kairotronix/kt_sound_pcb/README.md

# kt_sound_pcb

This is the schematic and PCB design files for interfacing with the DE10-Nano development kit for the KT Sound FPGA synthesizer design.
