kairotronix/kt_sound_pcb/DOC/kt_sound_prototypeiface.pdf

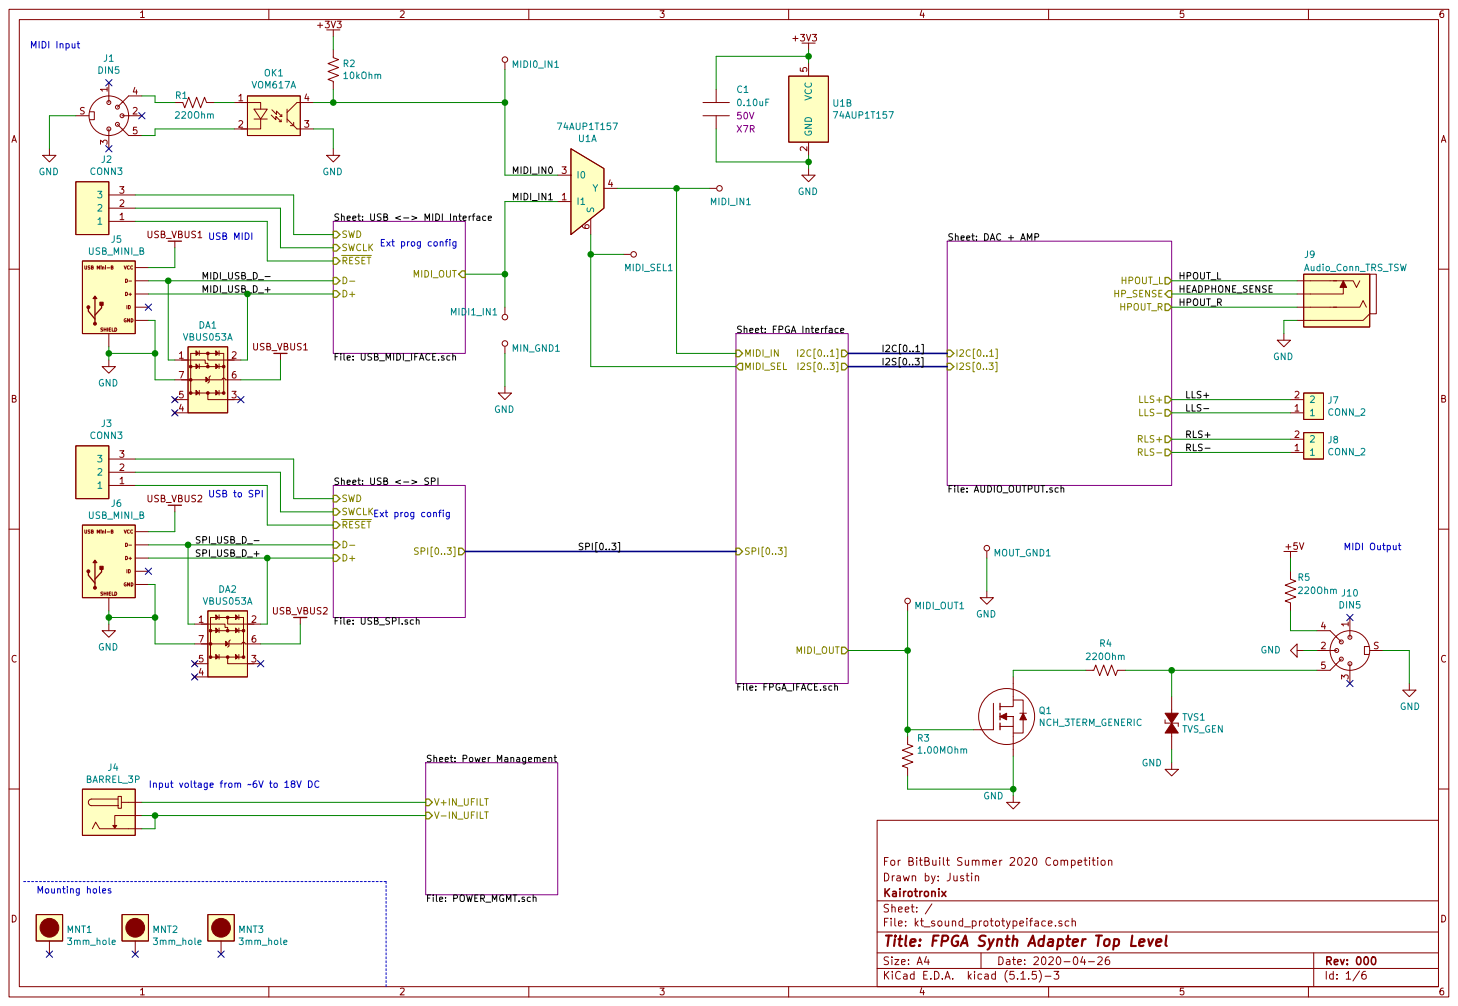
[picture p1: page 1]

I2C[0..1] | HPOUT_L HPOUT_R HP_SENSE LLS+

SWD Ext prog config

Input voltage from 6V to 18V DC

For BitBuilt Summer 2020 Competition
File: kt_sound_prototypeiface.sch Sheet: / Kairotronix Drawn by: Justin

Id: 1/6 Title: FPGA Synth Adapter Top Level

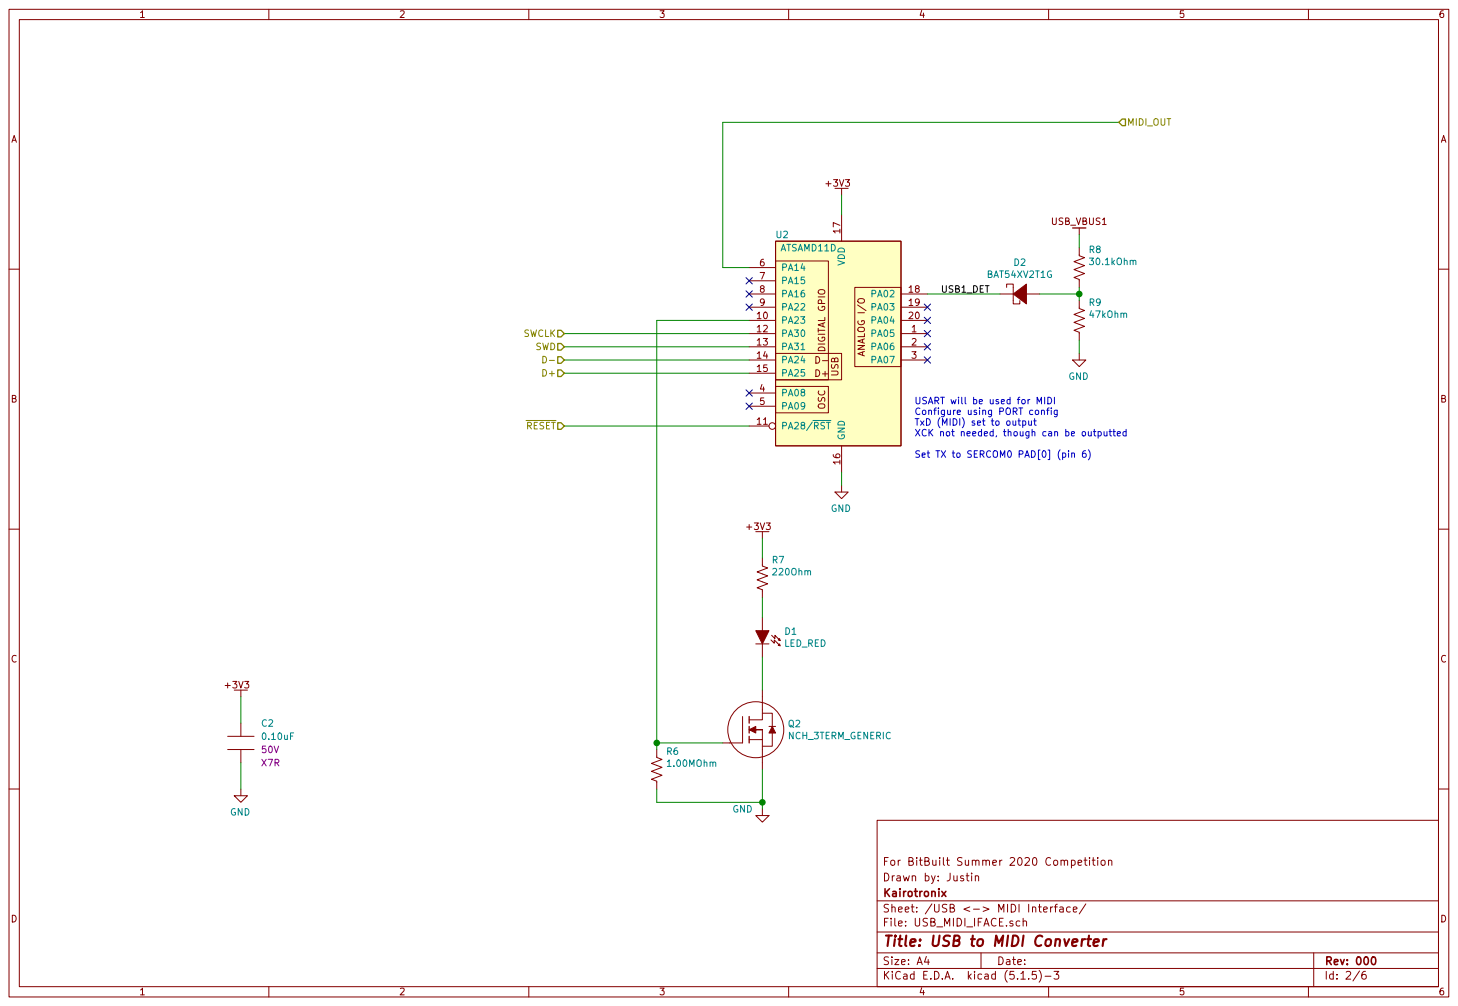
[picture p2: page 2]

TxD (MIDI) set to output
XCK not needed, though can be outputted

Set TX to SERCOM0 PAD[0] (pin 6)

For BitBuilt Summer 2020 Competition R6
1.00MOhm

File: USB_MIDI_IFACE.sch Sheet: /USB <-> MIDI Interface/ Kairotronix Drawn by: Justin

Id: 2/6 Title: USB to MIDI Converter

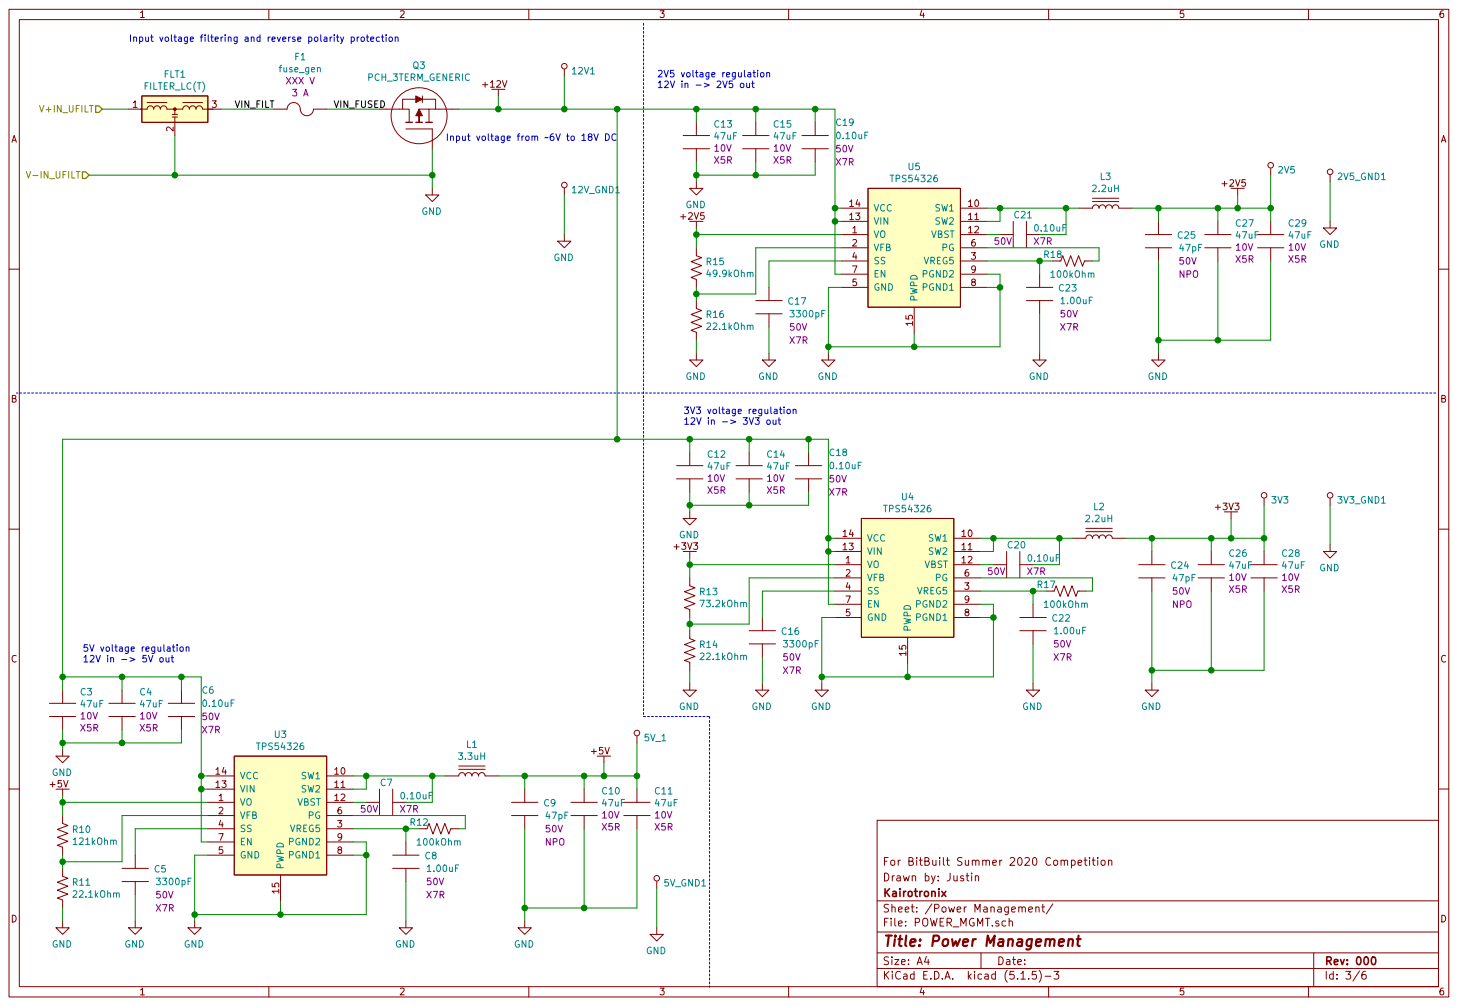
[picture p3: page 3]

Input voltage filtering and reverse polarity protection
3 FLT1 FILTER_LC(T) GND

12V_GND1 +12V Q3 PCH_3TERM_GENERIC GND
12V in -> 3V3 out 2V5 voltage regulation
12V in -> 2V5 out

Input voltage from 6V to 18V DC

For BitBuilt Summer 2020 Competition
Sheet: /Power Management/ Kairotronix Drawn by: Justin

File: POWER_MGMT.sch
Id: 3/6 Title: Power Management

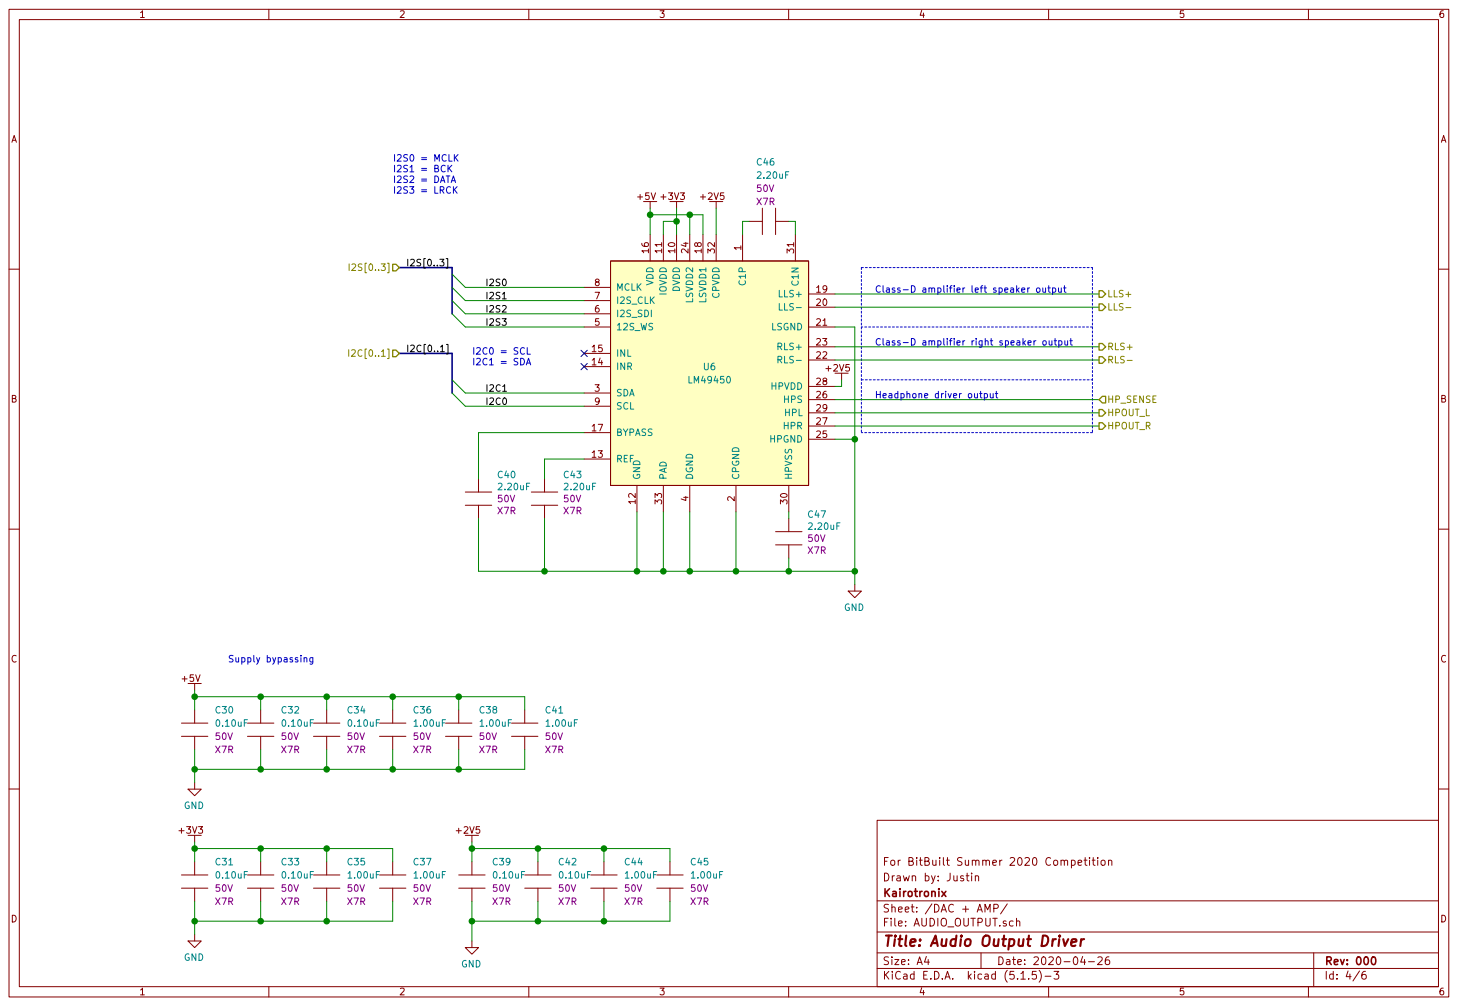
[picture p4: page 4]

1 DVDD 10 IOVDD 11 GND 12 REF 13

RLS+ RLS- LLS- LLS+ HP_SENSE HPOUT_R

Class-D amplifier right speaker output

For BitBuilt Summer 2020 Competition
File: AUDIO_OUTPUT.sch Sheet: /DAC + AMP/ Kairotronix Drawn by: Justin

Id: 4/6 Title: Audio Output Driver

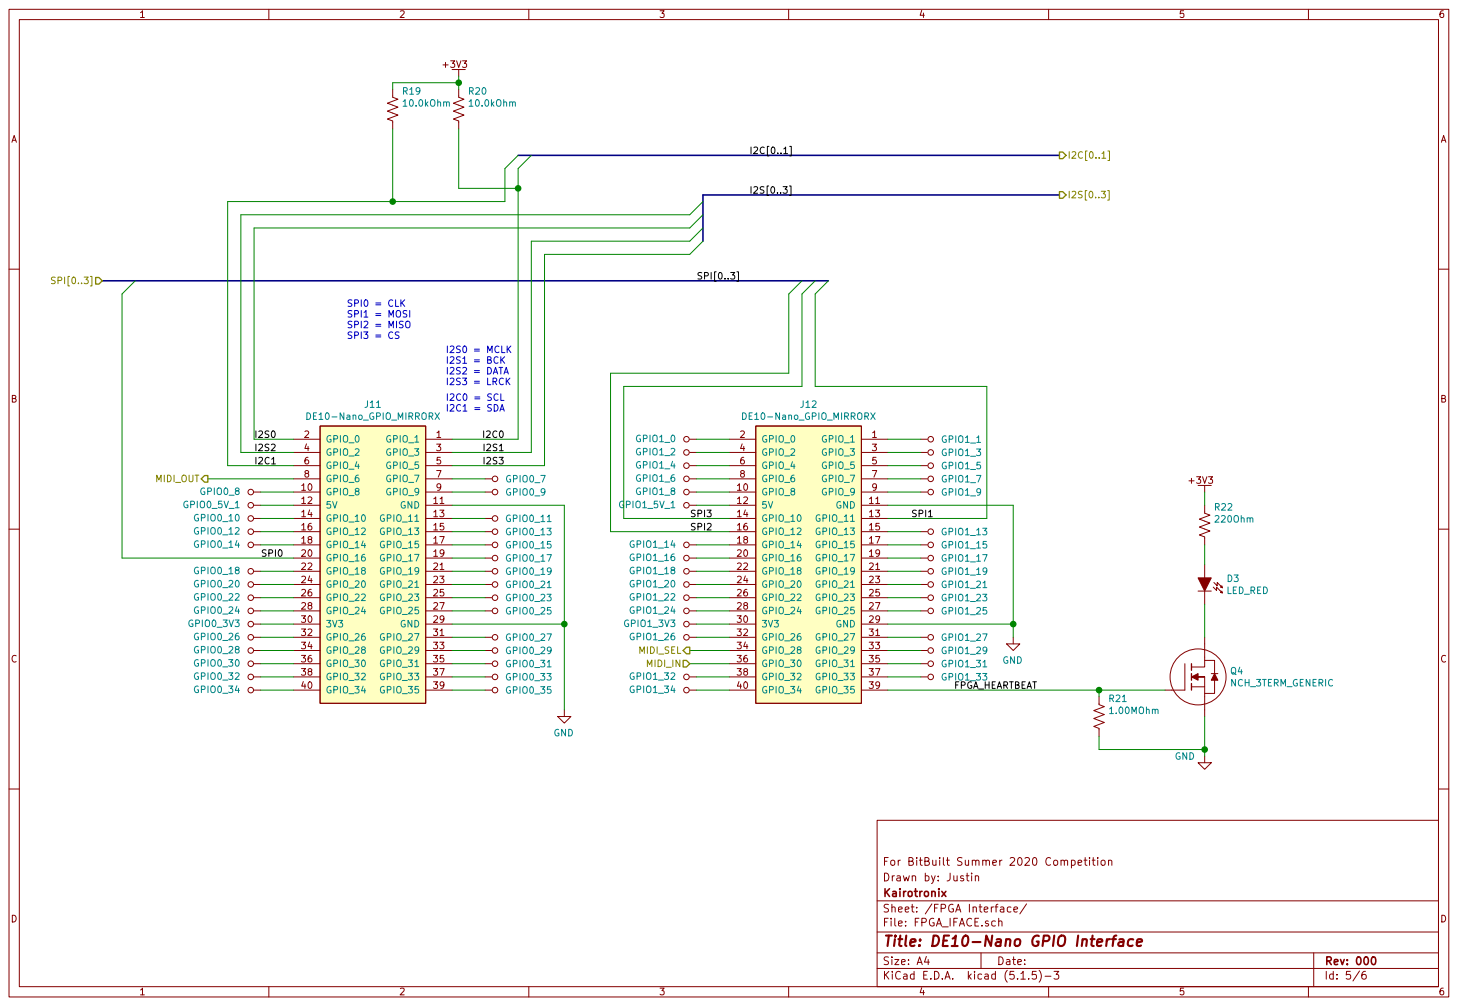
[picture p5: page 5]

File: FPGA_IFACE.sch Sheet: /FPGA Interface/ Kairotronix Drawn by: Justin

Id: 5/6 Title: DE10-Nano GPIO Interface

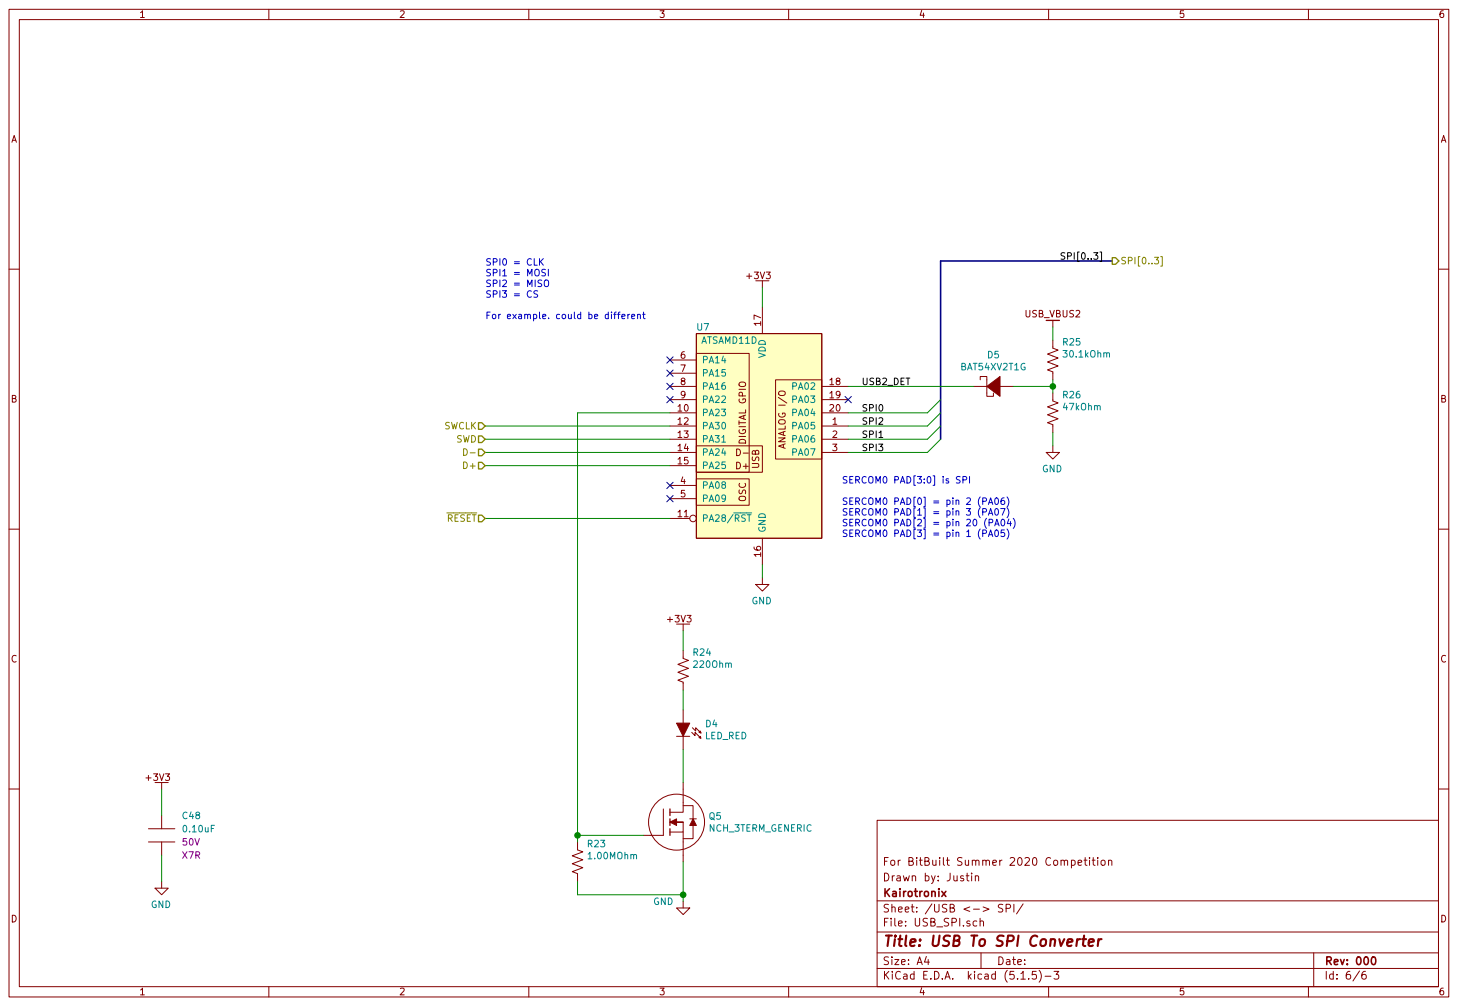
[picture p6: page 6]

For BitBuilt Summer 2020 Competition GND

For example. could be different

File: USB_SPI.sch Sheet: /USB <-> SPI/ Kairotronix Drawn by: Justin

Id: 6/6 Title: USB To SPI Converter
