kairotronix/kt_sound_pcb/kt_sound_prototypeiface.kicad_pcb

## KiCad design kt_sound_prototypeiface.kicad_pcb (2020-05-19)

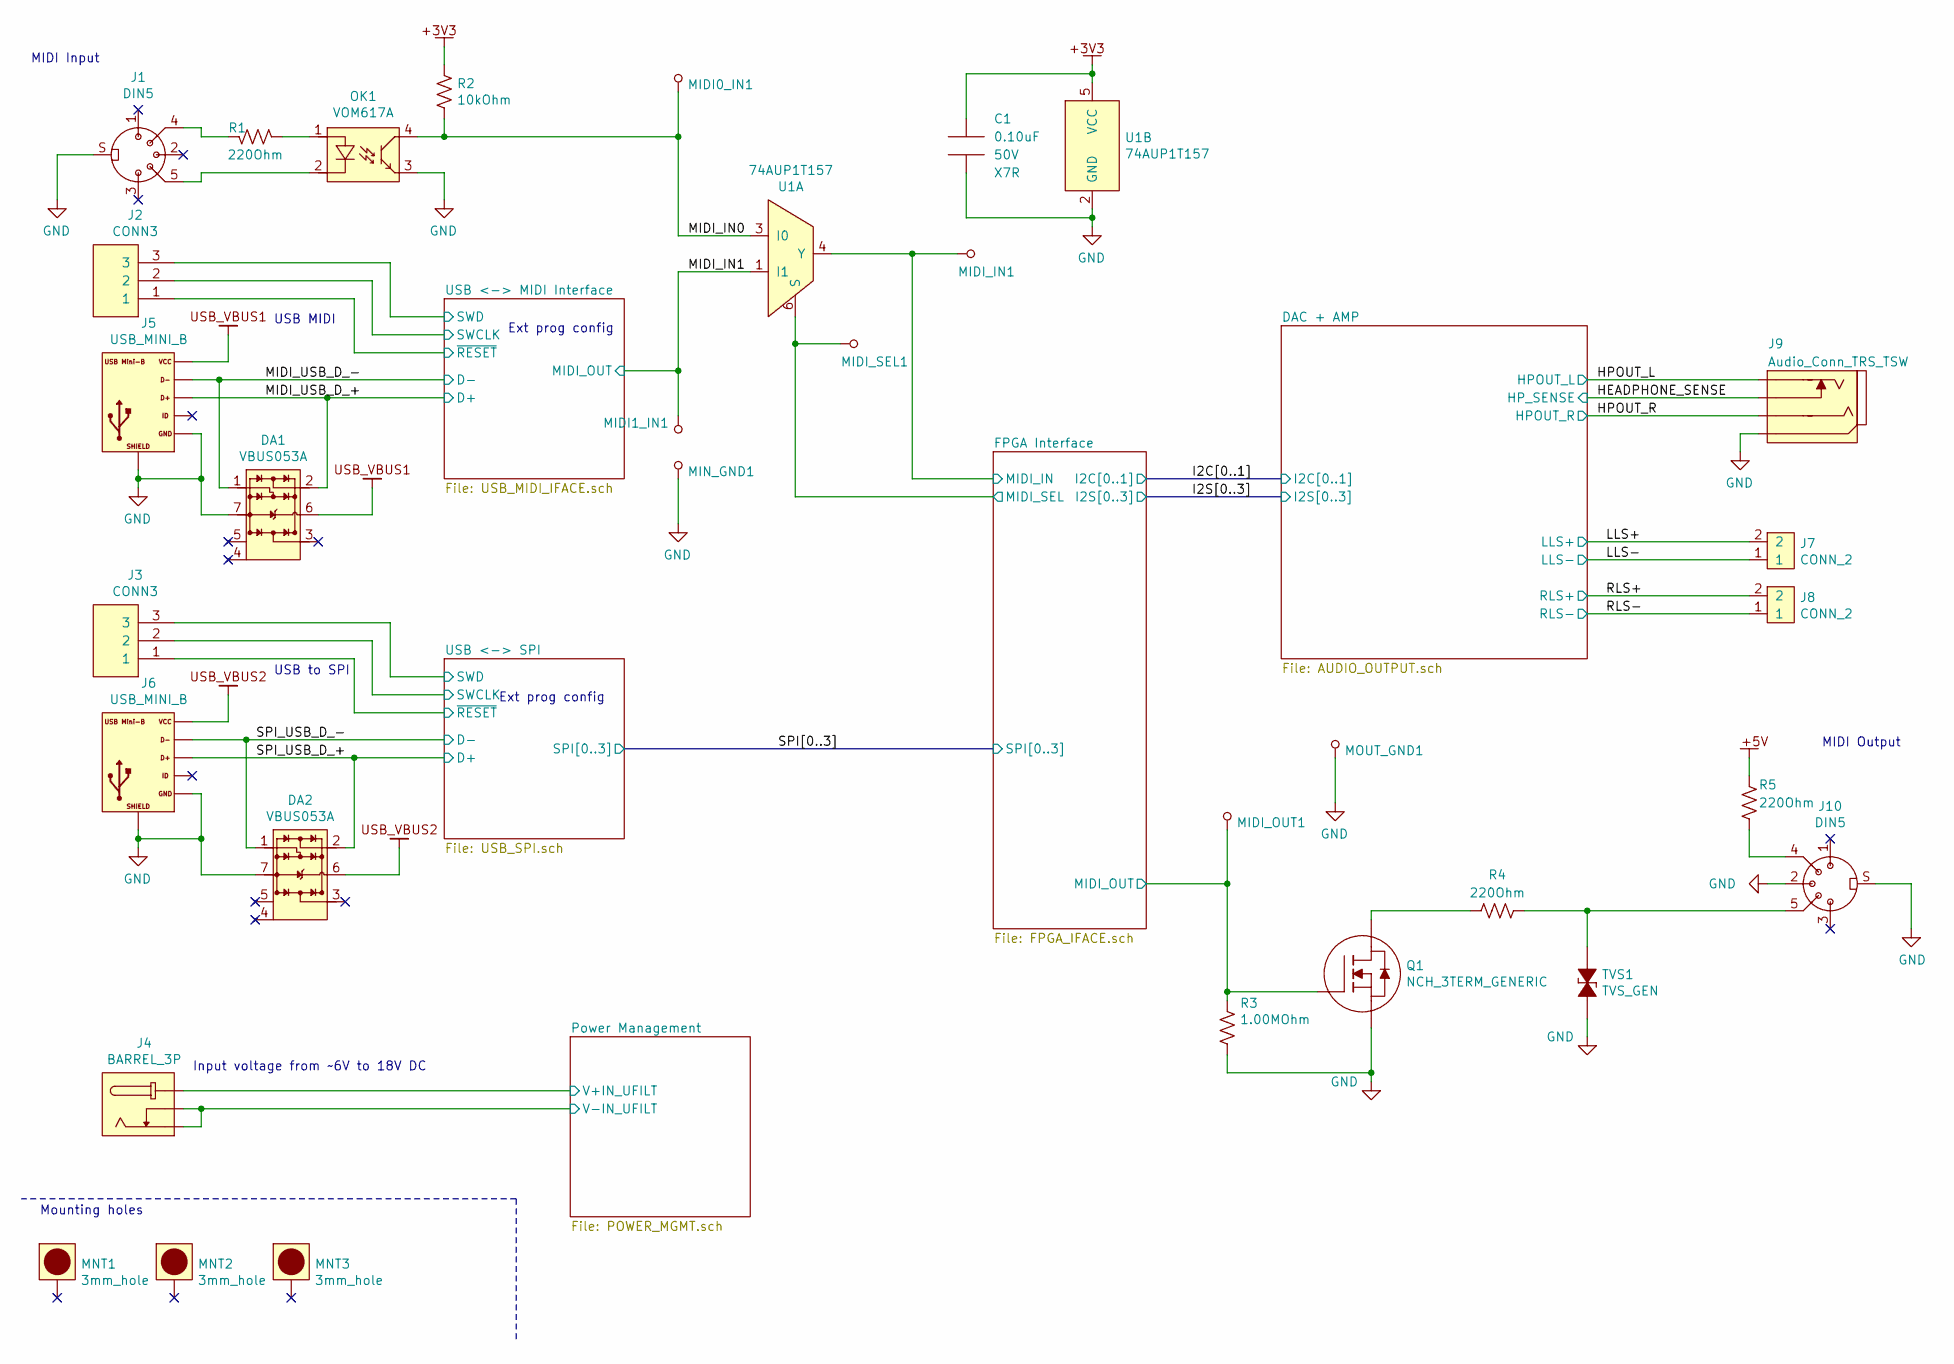
[picture p7: schematic kt_sound_prototypeiface.sch, FPGA Synth Adapter Top Level]

Parts:
C1: 0.10uF; CAP_0603; Voltage 50V; Tolerance XX %
DA1, DA2: VBUS053A; UFDFN-6-EP; MFG1 P/N VBUS053A
J1, J10: DIN5; DIN-5-CUI
J2, J3: CONN3; 1x03_0.1inch_vertical_header
J4: BARREL_3P; BarrelJack_CUI_PJ-102B; MFG1 P/N MFG1 P/N
J5, J6: USB_MINI_B; USB_MINIB_THT_TE_2172034-1
J7, J8: CONN_2; 1x02_0.1inch_vertical_header; MFG1 P/N MFG1 P/N
J9: Audio_Conn_TRS_TSW; Jack_3.5mm_CUI_SJ-3524-SMT; MFG1 P/N MFG1 P/N
MIDI0_IN1, MIDI1_IN1: TP_SMALL; TP_1mm; MFG P/N N/A
MIDI_IN1: TP_SMALL; TP_1mm; MFG P/N N/A
MIDI_OUT1: TP_SMALL; TP_1mm; MFG P/N N/A
MIDI_SEL1: TP_SMALL; TP_1mm; MFG P/N N/A
MIN_GND1: TP_SMALL; TP_1mm; MFG P/N N/A
MNT1, MNT2, MNT3: 3mm_hole; mnt_3mm_plated
MOUT_GND1: TP_SMALL; TP_1mm; MFG P/N N/A
OK1: VOM617A; 4-SMD_GW; MFG1 P/N VOM617A
Q1: NCH_3TERM_GENERIC; SOT23
R1: 220Ohm; RES_0603; Tolerance XX %
R2: 10kOhm; RES_0603; Tolerance XX %
R3: 1.00MOhm; RES_0603; Tolerance 10 %
R4, R5: 220Ohm; RES_0603; Tolerance 10 %
TVS1: TVS_GEN; SOD-523; Voltage - Reverse Stand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 X V; Voltage - Breakdown X V; MFG1 P/N MFG1 P/N
U1: 74AUP1T157; TSSOP-6; MFG1 P/N SN74AUP1T157

Connections:
3V3: C1.1, R2.1, U1.5 (VCC); also elsewhere on the board
5V: R5.2; also elsewhere on the board
/FPGA Interface/MIDI_IN: MIDI_IN1.1, U1.4 (Y); also elsewhere on the board
/FPGA Interface/MIDI_OUT: MIDI_OUT1.1, Q1.1 (G), R3.1; also elsewhere on the board
/FPGA Interface/MIDI_SEL: MIDI_SEL1.1, U1.6 (S); also elsewhere on the board
/HEADPHONE_SENSE: J9.10 (TS); also elsewhere on the board
/HPOUT_L: J9.2 (T); also elsewhere on the board
/HPOUT_R: J9.3 (R); also elsewhere on the board
/LLS+: J7.2; also elsewhere on the board
/LLS-: J7.1; also elsewhere on the board
/MIDI_IN0: MIDI0_IN1.1, OK1.4, R2.2, U1.3 (I0)
/MIDI_IN1: MIDI1_IN1.1, U1.1 (I1); also elsewhere on the board
/MIDI_USB_D_+: DA1.2 (I/O), J5.3; also elsewhere on the board
/MIDI_USB_D_-: DA1.1 (I/O), J5.2; also elsewhere on the board
/Power Management/V+IN_UFILT: J4.1 (BARREL); also elsewhere on the board
/RLS+: J8.2; also elsewhere on the board
/RLS-: J8.1; also elsewhere on the board
/SPI_USB_D_+: DA2.2 (I/O), J6.3; also elsewhere on the board
/SPI_USB_D_-: DA2.1 (I/O), J6.2; also elsewhere on the board
/USB <-> MIDI Interface/SWCLK: J2.2; also elsewhere on the board
/USB <-> MIDI Interface/SWD: J2.3; also elsewhere on the board
/USB <-> MIDI Interface/~RESET: J2.1; also elsewhere on the board
/USB <-> SPI/SWCLK: J3.2; also elsewhere on the board
/USB <-> SPI/SWD: J3.3; also elsewhere on the board
/USB <-> SPI/~RESET: J3.1; also elsewhere on the board
GND: C1.2, DA1.7 (GND), DA2.7 (GND), J1.S, J4.2 (SHIELD), J4.3 (CONTACT), J5.5, J5.SHIELD, J6.5, J6.SHIELD, J9.1 (S), J10.2, J10.S, MIN_GND1.1, MOUT_GND1.1, OK1.3, Q1.2 (S), R3.2, TVS1.2, U1.2 (GND); also elsewhere on the board
unnamed: J1.4, R1.1
unnamed: J1.5, OK1.2
unnamed: J10.4, R5.1
unnamed: J10.5, R4.1, TVS1.1
unnamed: OK1.1, R1.2
unnamed: Q1.3 (D), R4.2
USB_VBUS1: DA1.6 (V-), J5.1; also elsewhere on the board
USB_VBUS2: DA2.6 (V-), J6.1; also elsewhere on the board

Notes on the sheet:
USB to SPI
USB MIDI
MIDI Output
MIDI Input
Ext prog config
Input voltage from ~~6V to 18V DC
Mounting holes

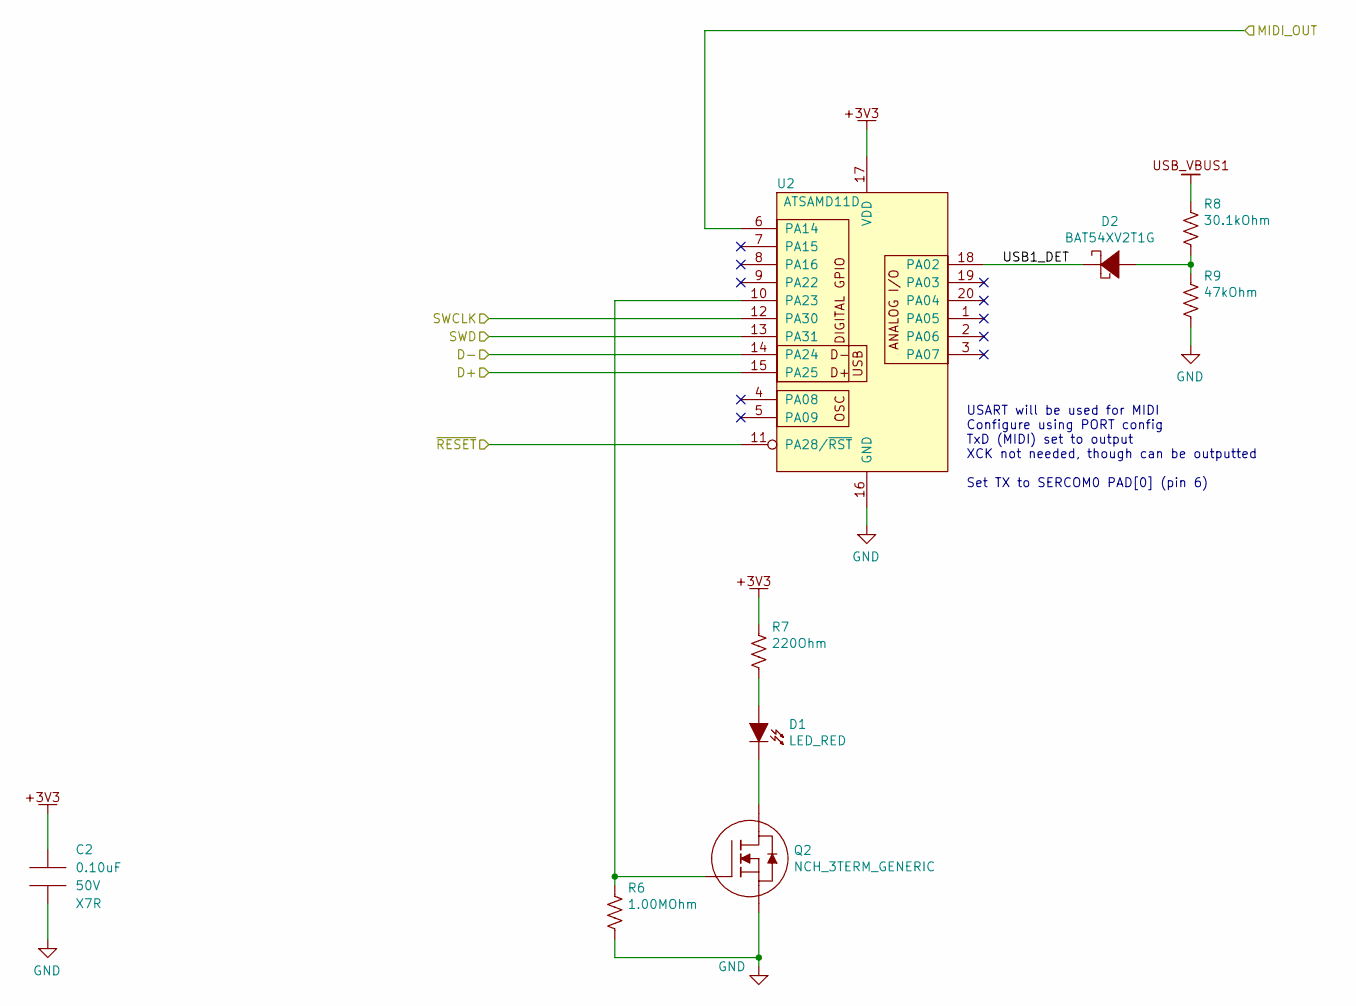
[picture p8: schematic USB_MIDI_IFACE.sch, USB to MIDI Converter]

Parts:
C2: 0.10uF; CAP_0603; Voltage 50V; Tolerance XX %
D1: LED_RED; LED_0805
D2: BAT54XV2T1G; SOD-523
Q2: NCH_3TERM_GENERIC; SOT23
R6: 1.00MOhm; RES_0603; Tolerance 10 %
R7: 220Ohm; RES_0603; Tolerance XX %
R8: 30.1kOhm; RES_0603; Tolerance XX %
R9: 47kOhm; RES_0603; Tolerance XX %
U2: ATSAMD11D; SOIC-20; MFG1 P/N ATSAMD11D14A-SSUT

Connections:
3V3: C2.1, R7.1, U2.17 (VDD); also elsewhere on the board
/MIDI_IN1: U2.6 (PA14); also elsewhere on the board
/MIDI_USB_D_+: U2.15 (PA25); also elsewhere on the board
/MIDI_USB_D_-: U2.14 (PA24); also elsewhere on the board
/USB <-> MIDI Interface/SWCLK: U2.12 (PA30); also elsewhere on the board
/USB <-> MIDI Interface/SWD: U2.13 (PA31); also elsewhere on the board
/USB <-> MIDI Interface/USB1_DET: D2.2, U2.18 (PA02)
/USB <-> MIDI Interface/~RESET: U2.11 (PA28/~RST); also elsewhere on the board
GND: C2.2, Q2.2 (S), R6.2, R9.2, U2.16 (GND); also elsewhere on the board
unnamed: D1.1, R7.2
unnamed: D1.2, Q2.3 (D)
unnamed: D2.1, R8.2, R9.1
unnamed: Q2.1 (G), R6.1, U2.10 (PA23)
USB_VBUS1: R8.1; also elsewhere on the board

Notes on the sheet:
USART will be used for MIDI Configure using PORT config TxD (MIDI) set to output XCK not needed, though can be outputted Set TX to SERCOM0 PAD[0] (pin 6)

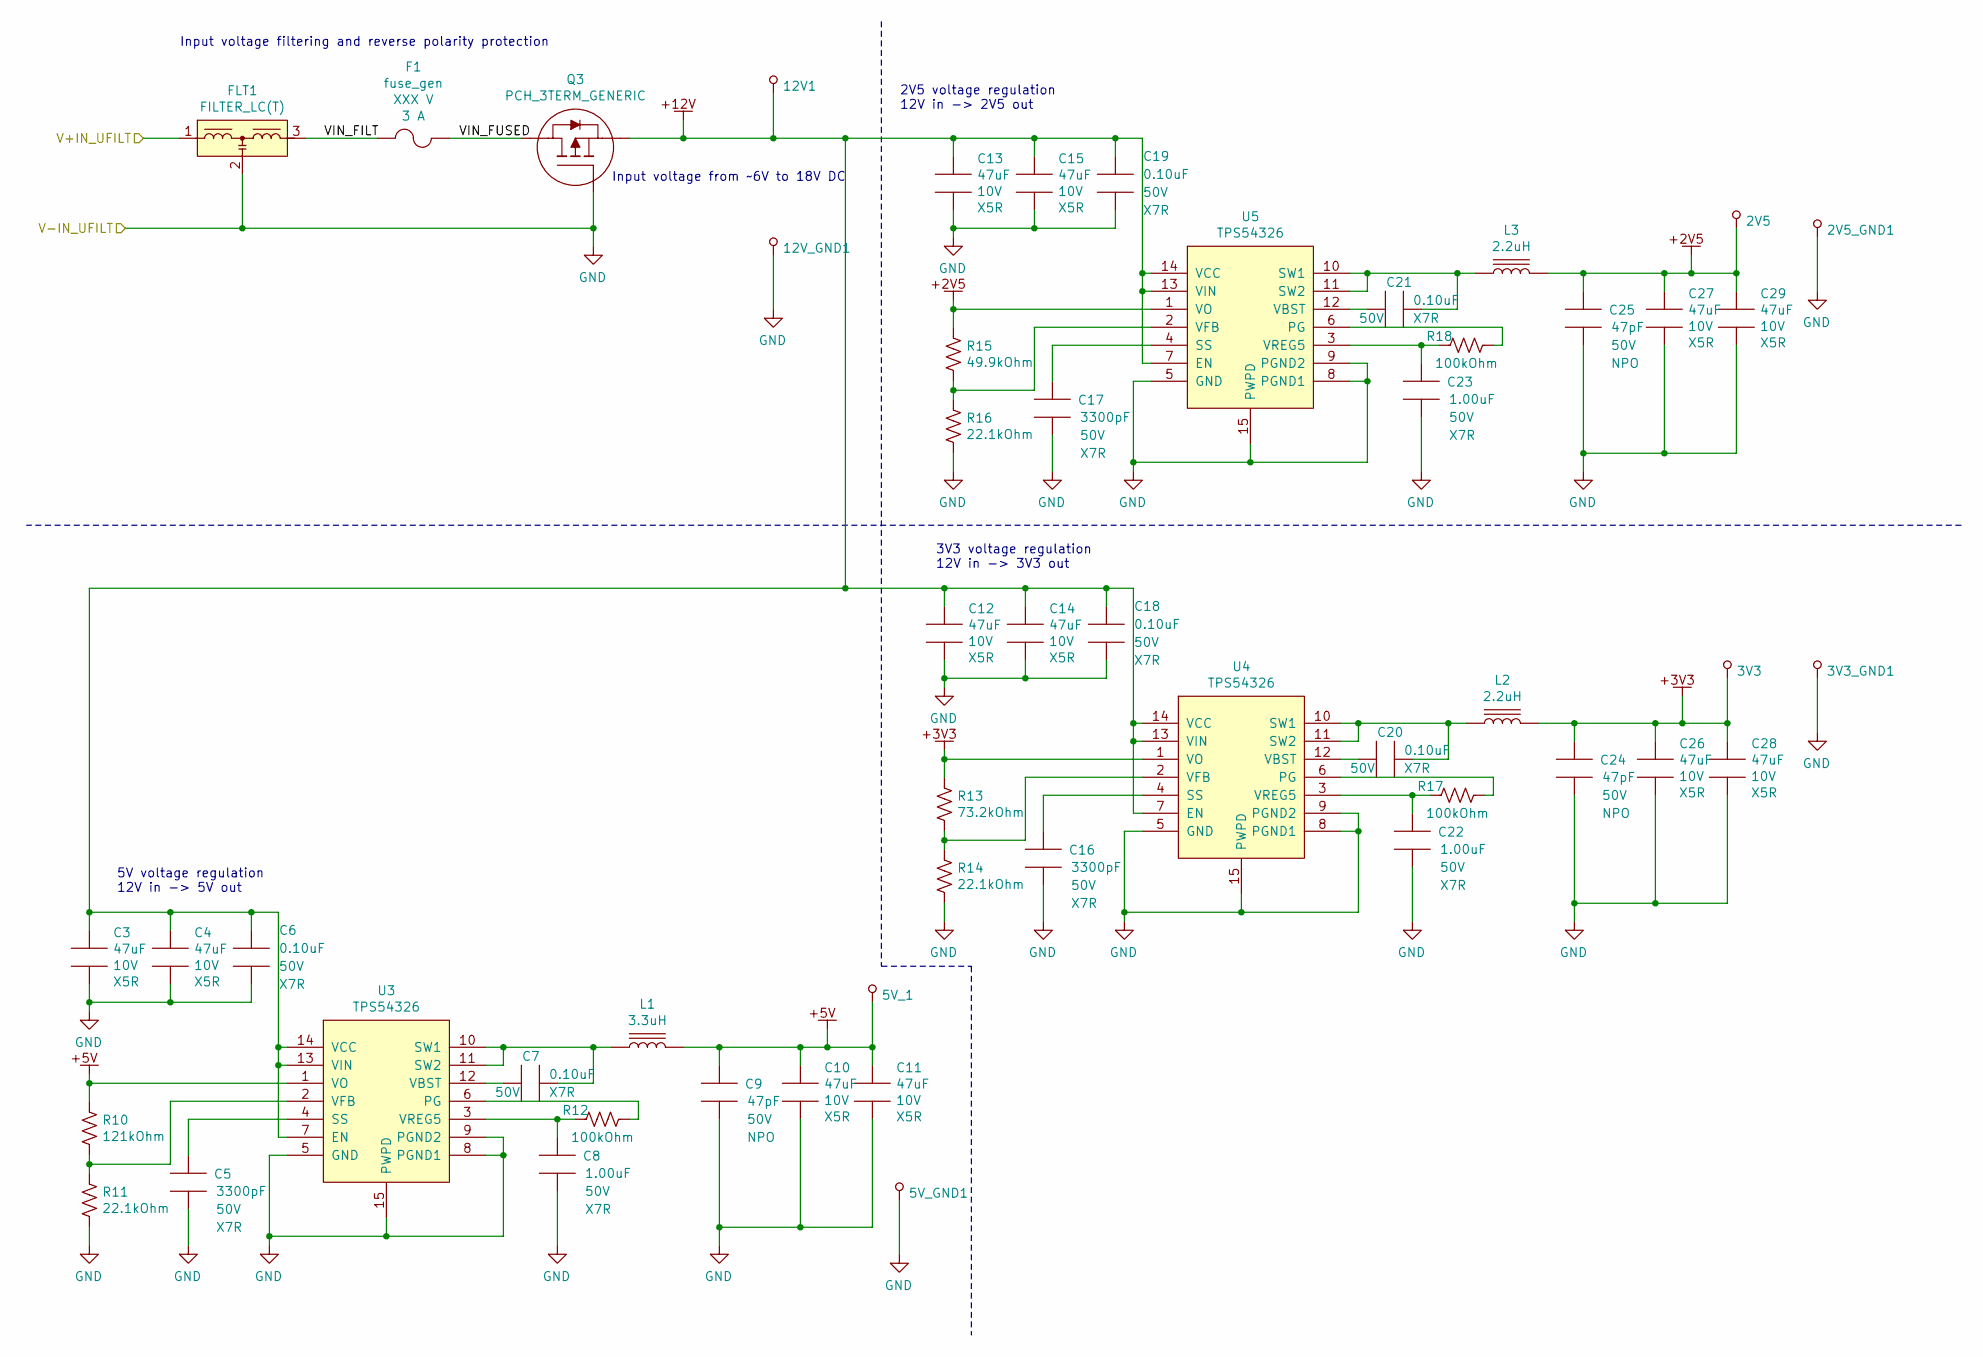
[picture p9: schematic POWER_MGMT.sch, Power Management]

Parts:
2V5, 2V5_GND1, 3V3, 3V3_GND1, 5V_1, 5V_GND1, 12V1, 12V_GND1: TP_SMALL; TP_1mm; MFG P/N N/A
C3, C4, C10, C11, C12, C13, C14, C15, C26, C27, C28, C29: 47uF; CAP_0805; Voltage 10V; Tolerance XX %
C5, C16, C17: 3300pF; CAP_0603; Voltage 50V; Tolerance XX %
C6, C7, C18, C19, C20, C21: 0.10uF; CAP_0603; Voltage 50V; Tolerance XX %
C8, C22, C23: 1.00uF; CAP_0603; Voltage 50V; Tolerance XX %
C9, C24, C25: 47pF; CAP_0603; Voltage 50V; Tolerance XX %
F1: fuse_gen; RES_0603; Voltage XXX V; MFG1 P/N MFG1 P/N
FLT1: FILTER_LC(T); FIL_NFE31PT222Z1E9L
L1: 3.3uH; L_Radial_THT_5mm; Voltage X V; MFG1 P/N MFG1 P/N
L2, L3: 2.2uH; L_Radial_THT_5mm; Voltage X V; MFG1 P/N MFG1 P/N
Q3: PCH_3TERM_GENERIC; SOT23
R10: 121kOhm; RES_0603; Tolerance XX %
R11, R14, R16: 22.1kOhm; RES_0603; Tolerance XX %
R12, R17, R18: 100kOhm; RES_0603; Tolerance XX %
R13: 73.2kOhm; RES_0603; Tolerance XX %
R15: 49.9kOhm; RES_0603; Tolerance XX %
U3, U4, U5: TPS54326; HTSSOP-14-EP; MFG1 P/N TPS54326

Connections:
2V5: 2V5.1, C25.1, C27.1, C29.1, L3.2, R15.1, U5.1 (VO); also elsewhere on the board
3V3: 3V3.1, C24.1, C26.1, C28.1, L2.2, R13.1, U4.1 (VO); also elsewhere on the board
5V: 5V_1.1, C9.1, C10.1, C11.1, L1.2, R10.1, U3.1 (VO); also elsewhere on the board
12V: 12V1.1, C3.1, C4.1, C6.1, C12.1, C13.1, C14.1, C15.1, C18.1, C19.1, Q3.2 (S), U3.7 (EN), U3.13 (VIN), U3.14 (VCC), U4.7 (EN), U4.13 (VIN), U4.14 (VCC), U5.7 (EN), U5.13 (VIN), U5.14 (VCC)
/Power Management/V+IN_UFILT: FLT1.1 (Input); also elsewhere on the board
/Power Management/VIN_FILT: F1.1, FLT1.3 (Output)
/Power Management/VIN_FUSED: F1.2, Q3.3 (D)
GND: 2V5_GND1.1, 3V3_GND1.1, 5V_GND1.1, 12V_GND1.1, C3.2, C4.2, C5.2, C6.2, C8.2, C9.2, C10.2, C11.2, C12.2, C13.2, C14.2, C15.2, C16.2, C17.2, C18.2, C19.2, C22.2, C23.2, C24.2, C25.2, C26.2, C27.2, C28.2, C29.2, FLT1.2 (GND), Q3.1 (G), R11.2, R14.2, R16.2, U3.5 (GND), U3.8 (PGND1), U3.9 (PGND2), U3.15 (PWPD), U4.5 (GND), U4.8 (PGND1), U4.9 (PGND2), U4.15 (PWPD), U5.5 (GND), U5.8 (PGND1), U5.9 (PGND2), U5.15 (PWPD); also elsewhere on the board
unnamed: C5.1, U3.4 (SS)
unnamed: C7.1, U3.12 (VBST)
unnamed: C7.2, L1.1, U3.10 (SW1), U3.11 (SW2)
unnamed: C8.1, R12.1, U3.3 (VREG5)
unnamed: C16.1, U4.4 (SS)
unnamed: C17.1, U5.4 (SS)
unnamed: C20.1, U4.12 (VBST)
unnamed: C20.2, L2.1, U4.10 (SW1), U4.11 (SW2)
unnamed: C21.1, U5.12 (VBST)
unnamed: C21.2, L3.1, U5.10 (SW1), U5.11 (SW2)
unnamed: C22.1, R17.1, U4.3 (VREG5)
unnamed: C23.1, R18.1, U5.3 (VREG5)
unnamed: R10.2, R11.1, U3.2 (VFB)
unnamed: R12.2, U3.6 (PG)
unnamed: R13.2, R14.1, U4.2 (VFB)
unnamed: R15.2, R16.1, U5.2 (VFB)
unnamed: R17.2, U4.6 (PG)
unnamed: R18.2, U5.6 (PG)

Notes on the sheet:
2V5 voltage regulation 12V in -> 2V5 out
3V3 voltage regulation 12V in -> 3V3 out
5V voltage regulation 12V in -> 5V out
Input voltage filtering and reverse polarity protection
Input voltage from ~~6V to 18V DC

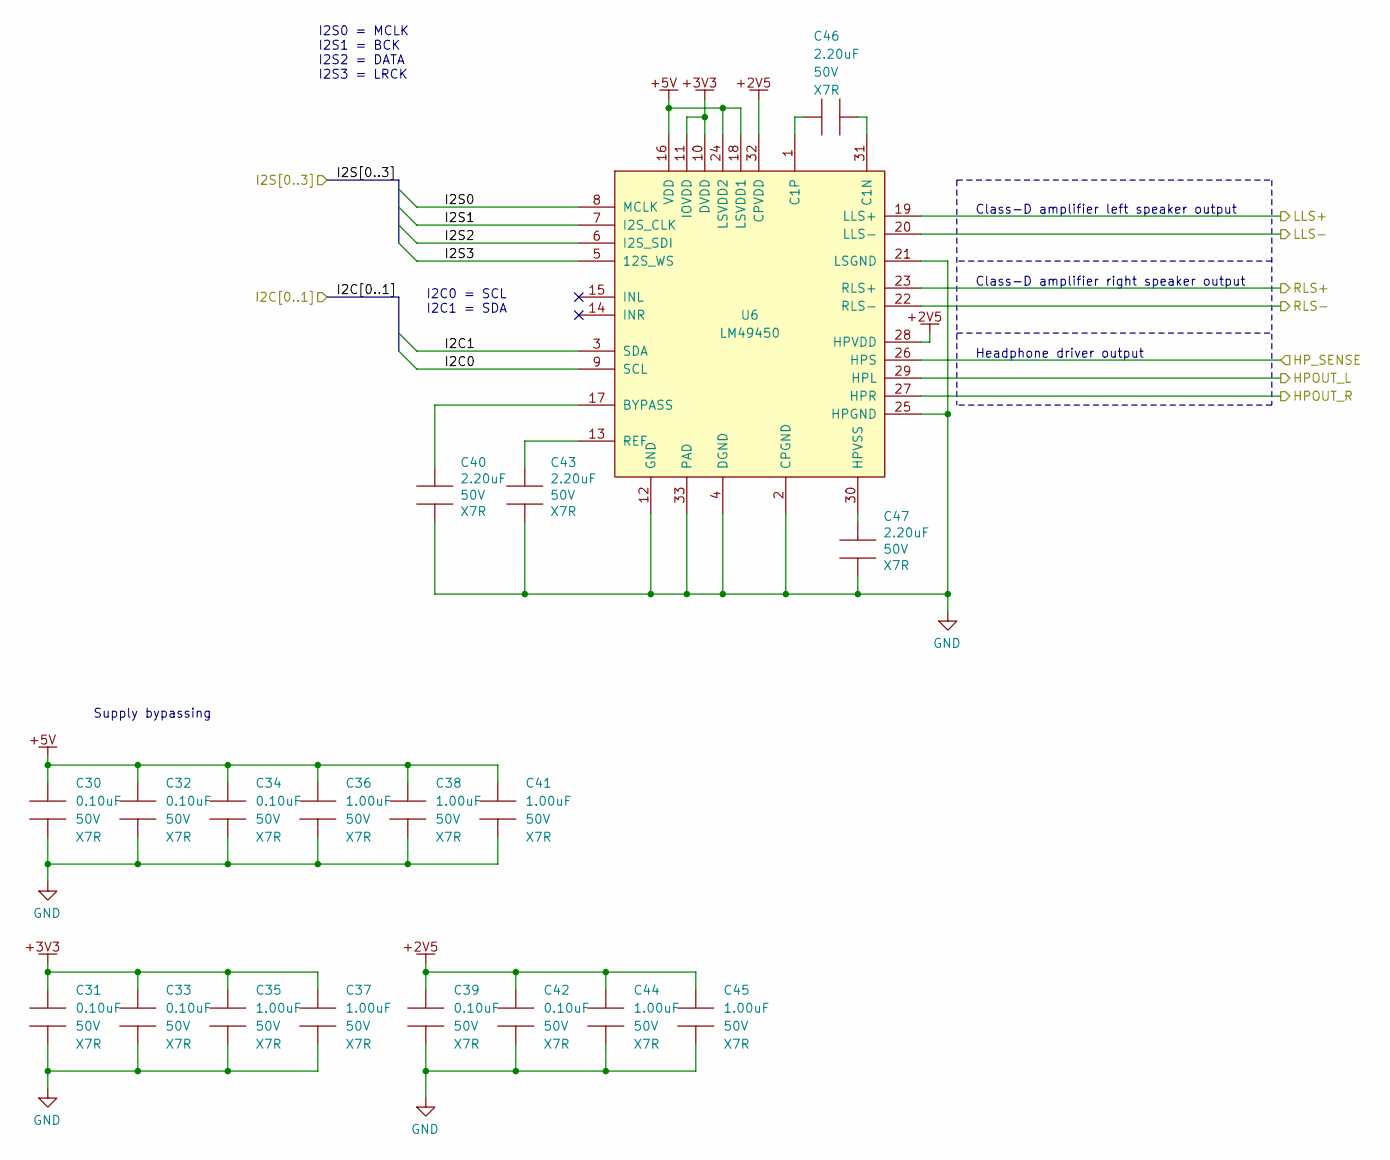
[picture p10: schematic AUDIO_OUTPUT.sch, Audio Output Driver]

Parts:
C30, C31, C32, C33, C34, C39, C42: 0.10uF; CAP_0603; Voltage 50V; Tolerance XX %
C35, C36, C37, C38, C41, C44, C45: 1.00uF; CAP_0603; Voltage 50V; Tolerance XX %
C40, C43, C46, C47: 2.20uF; CAP_0603; Voltage 50V; Tolerance XX %
U6: LM49450; WQFN-32; MFG1 P/N LM49450

Connections:
2V5: C39.1, C42.1, C44.1, C45.1, U6.28 (HPVDD), U6.32 (CPVDD); also elsewhere on the board
3V3: C31.1, C33.1, C35.1, C37.1, U6.10 (DVDD), U6.11 (IOVDD); also elsewhere on the board
5V: C30.1, C32.1, C34.1, C36.1, C38.1, C41.1, U6.16 (VDD), U6.18 (LSVDD1), U6.24 (LSVDD2); also elsewhere on the board
/DAC + AMP/I2C0: U6.9 (SCL); also elsewhere on the board
/DAC + AMP/I2C1: U6.3 (SDA); also elsewhere on the board
/DAC + AMP/I2S0: U6.8 (MCLK); also elsewhere on the board
/DAC + AMP/I2S1: U6.7 (I2S_CLK); also elsewhere on the board
/DAC + AMP/I2S2: U6.6 (I2S_SDI); also elsewhere on the board
/DAC + AMP/I2S3: U6.5 (12S_WS); also elsewhere on the board
/HEADPHONE_SENSE: U6.26 (HPS); also elsewhere on the board
/HPOUT_L: U6.29 (HPL); also elsewhere on the board
/HPOUT_R: U6.27 (HPR); also elsewhere on the board
/LLS+: U6.19 (LLS+); also elsewhere on the board
/LLS-: U6.20 (LLS-); also elsewhere on the board
/RLS+: U6.23 (RLS+); also elsewhere on the board
/RLS-: U6.22 (RLS-); also elsewhere on the board
GND: C30.2, C31.2, C32.2, C33.2, C34.2, C35.2, C36.2, C37.2, C38.2, C39.2, C40.2, C41.2, C42.2, C43.2, C44.2, C45.2, C47.2, U6.2 (CPGND), U6.4 (DGND), U6.12 (GND), U6.21 (LSGND), U6.25 (HPGND), U6.33 (PAD); also elsewhere on the board
unnamed: C40.1, U6.17 (BYPASS)
unnamed: C43.1, U6.13 (REF)
unnamed: C46.1, U6.1 (C1P)
unnamed: C46.2, U6.31 (C1N)
unnamed: C47.1, U6.30 (HPVSS)

Notes on the sheet:
Class-D amplifier left speaker output
Class-D amplifier right speaker output
Headphone driver output
Supply bypassing
I2S0 = MCLK I2S1 = BCK I2S2 = DATA I2S3 = LRCK
I2C0 = SCL I2C1 = SDA

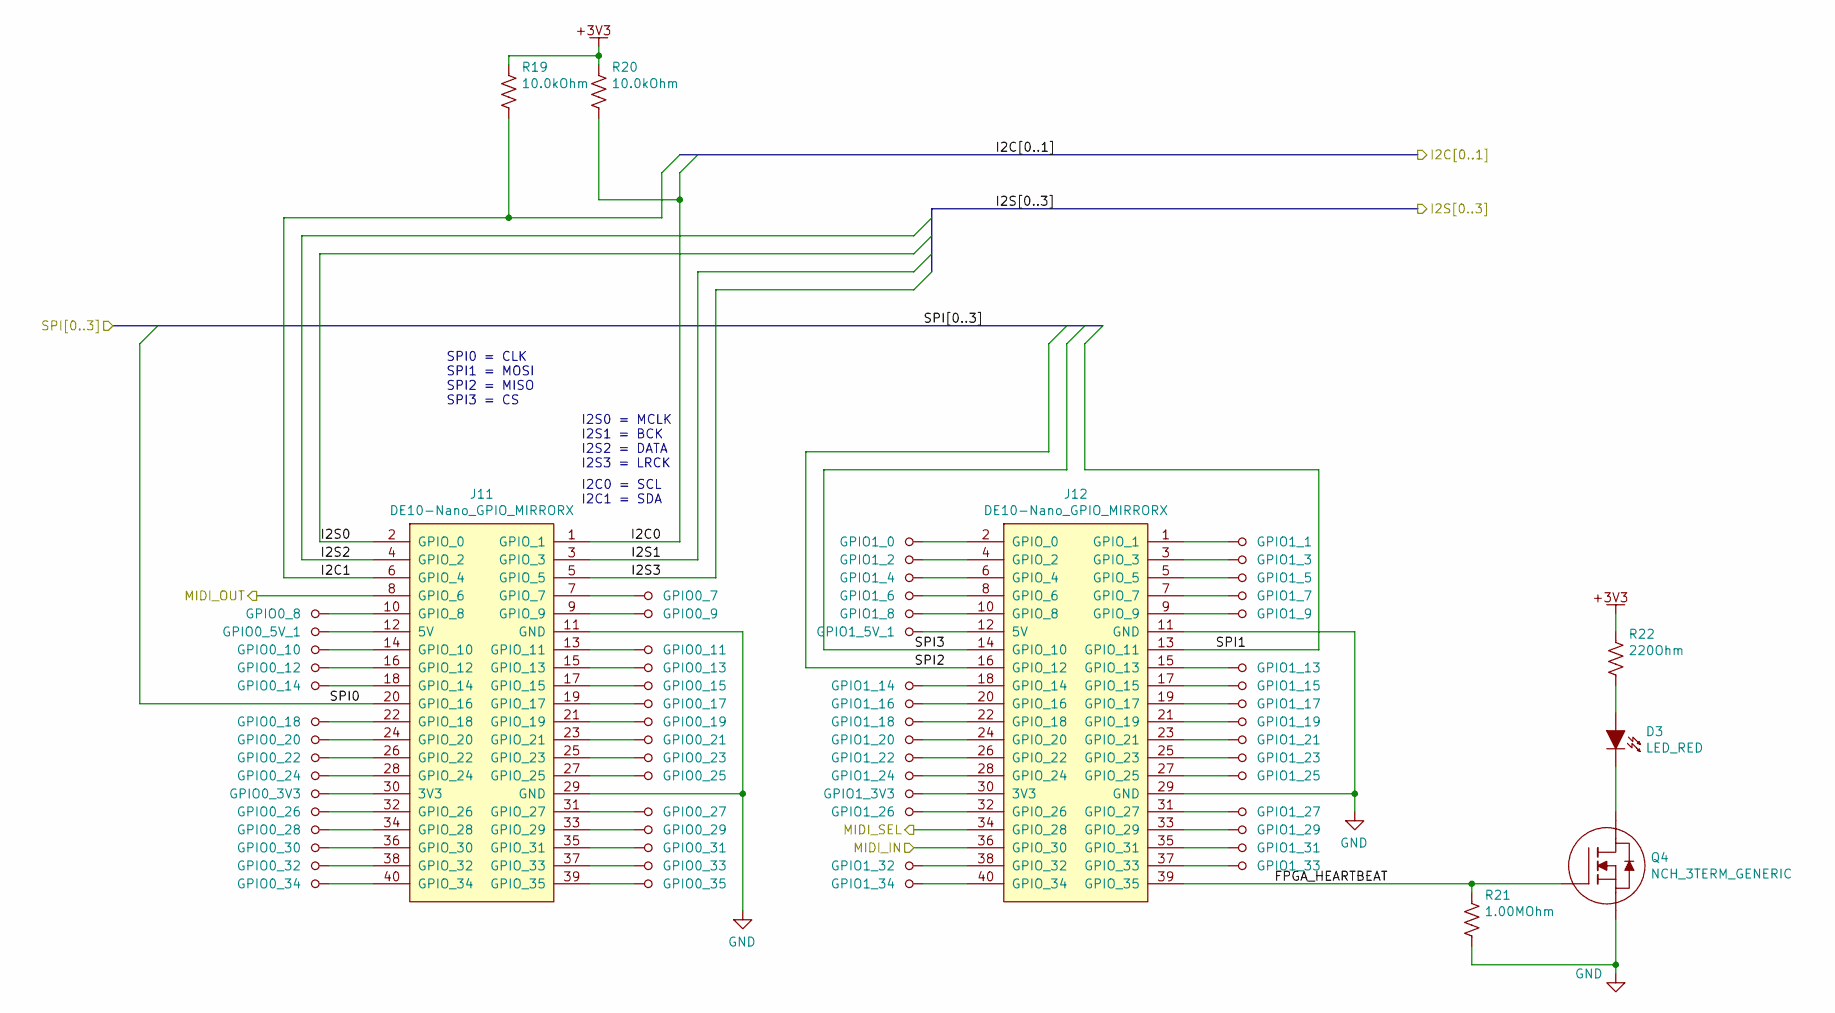
[picture p11: schematic FPGA_IFACE.sch, DE10-Nano GPIO Interface]

Parts:
D3: LED_RED; LED_0805
GPIO0_3V3, GPIO0_5V_1, GPIO0_7, GPIO0_8, GPIO0_9, GPIO0_10, GPIO0_11, GPIO0_12, GPIO0_13, GPIO0_14, GPIO0_15, GPIO0_17, GPIO0_18, GPIO0_19, GPIO0_20, GPIO0_21, GPIO0_22, GPIO0_23, GPIO0_24, GPIO0_25, GPIO0_26, GPIO0_27, GPIO0_28, GPIO0_29, GPIO0_30, GPIO0_31, GPIO0_32, GPIO0_33, GPIO0_34, GPIO0_35, GPIO1_0, GPIO1_1, GPIO1_2, GPIO1_3, GPIO1_3V3, GPIO1_4, GPIO1_5, GPIO1_5V_1, GPIO1_6, GPIO1_7, GPIO1_8, GPIO1_9, GPIO1_13, GPIO1_14, GPIO1_15, GPIO1_16, GPIO1_17, GPIO1_18, GPIO1_19, GPIO1_20, GPIO1_21, GPIO1_22, GPIO1_23, GPIO1_24, GPIO1_25, GPIO1_26, GPIO1_27, GPIO1_29, GPIO1_31, GPIO1_32, GPIO1_33, GPIO1_34: TP_SMALL; TP_1mm; MFG P/N N/A
J11, J12: DE10-Nano_GPIO_MIRRORX; DE10_GPIO_HEADER
Q4: NCH_3TERM_GENERIC; SOT23
R19, R20: 10.0kOhm; RES_0603; Tolerance XX %
R21: 1.00MOhm; RES_0603; Tolerance 10 %
R22: 220Ohm; RES_0603; Tolerance XX %

Connections:
3V3: R19.1, R20.1, R22.1; also elsewhere on the board
/DAC + AMP/I2C0: J11.1 (GPIO_1), R20.2; also elsewhere on the board
/DAC + AMP/I2C1: J11.6 (GPIO_4), R19.2; also elsewhere on the board
/DAC + AMP/I2S0: J11.2 (GPIO_0); also elsewhere on the board
/DAC + AMP/I2S1: J11.3 (GPIO_3); also elsewhere on the board
/DAC + AMP/I2S2: J11.4 (GPIO_2); also elsewhere on the board
/DAC + AMP/I2S3: J11.5 (GPIO_5); also elsewhere on the board
/FPGA Interface/FPGA_HEARTBEAT: J12.39 (GPIO_35), Q4.1 (G), R21.1
/FPGA Interface/MIDI_IN: J12.36 (GPIO_30); also elsewhere on the board
/FPGA Interface/MIDI_OUT: J11.8 (GPIO_6); also elsewhere on the board
/FPGA Interface/MIDI_SEL: J12.34 (GPIO_28); also elsewhere on the board
/FPGA Interface/SPI0: J11.20 (GPIO_16); also elsewhere on the board
/FPGA Interface/SPI1: J12.13 (GPIO_11); also elsewhere on the board
/FPGA Interface/SPI2: J12.16 (GPIO_12); also elsewhere on the board
/FPGA Interface/SPI3: J12.14 (GPIO_10); also elsewhere on the board
GND: J11.11 (GND), J11.29 (GND), J12.11 (GND), J12.29 (GND), Q4.2 (S), R21.2; also elsewhere on the board
unnamed: D3.1, R22.2
unnamed: D3.2, Q4.3 (D)
unnamed: GPIO0_3V3.1, J11.30 (3V3)
unnamed: GPIO0_5V_1.1, J11.12 (5V)
unnamed: GPIO0_7.1, J11.7 (GPIO_7)
unnamed: GPIO0_8.1, J11.10 (GPIO_8)
unnamed: GPIO0_9.1, J11.9 (GPIO_9)
unnamed: GPIO0_10.1, J11.14 (GPIO_10)
unnamed: GPIO0_11.1, J11.13 (GPIO_11)
unnamed: GPIO0_12.1, J11.16 (GPIO_12)
unnamed: GPIO0_13.1, J11.15 (GPIO_13)
unnamed: GPIO0_14.1, J11.18 (GPIO_14)
unnamed: GPIO0_15.1, J11.17 (GPIO_15)
unnamed: GPIO0_17.1, J11.19 (GPIO_17)
unnamed: GPIO0_18.1, J11.22 (GPIO_18)
unnamed: GPIO0_19.1, J11.21 (GPIO_19)
unnamed: GPIO0_20.1, J11.24 (GPIO_20)
unnamed: GPIO0_21.1, J11.23 (GPIO_21)
unnamed: GPIO0_22.1, J11.26 (GPIO_22)
unnamed: GPIO0_23.1, J11.25 (GPIO_23)
unnamed: GPIO0_24.1, J11.28 (GPIO_24)
unnamed: GPIO0_25.1, J11.27 (GPIO_25)
unnamed: GPIO0_26.1, J11.32 (GPIO_26)
unnamed: GPIO0_27.1, J11.31 (GPIO_27)
unnamed: GPIO0_28.1, J11.34 (GPIO_28)
unnamed: GPIO0_29.1, J11.33 (GPIO_29)
unnamed: GPIO0_30.1, J11.36 (GPIO_30)
unnamed: GPIO0_31.1, J11.35 (GPIO_31)
unnamed: GPIO0_32.1, J11.38 (GPIO_32)
unnamed: GPIO0_33.1, J11.37 (GPIO_33)
unnamed: GPIO0_34.1, J11.40 (GPIO_34)
unnamed: GPIO0_35.1, J11.39 (GPIO_35)
unnamed: GPIO1_0.1, J12.2 (GPIO_0)
unnamed: GPIO1_1.1, J12.1 (GPIO_1)
unnamed: GPIO1_2.1, J12.4 (GPIO_2)
unnamed: GPIO1_3.1, J12.3 (GPIO_3)
unnamed: GPIO1_3V3.1, J12.30 (3V3)
unnamed: GPIO1_4.1, J12.6 (GPIO_4)
unnamed: GPIO1_5.1, J12.5 (GPIO_5)
unnamed: GPIO1_5V_1.1, J12.12 (5V)
unnamed: GPIO1_6.1, J12.8 (GPIO_6)
unnamed: GPIO1_7.1, J12.7 (GPIO_7)
unnamed: GPIO1_8.1, J12.10 (GPIO_8)
unnamed: GPIO1_9.1, J12.9 (GPIO_9)
unnamed: GPIO1_13.1, J12.15 (GPIO_13)
unnamed: GPIO1_14.1, J12.18 (GPIO_14)
unnamed: GPIO1_15.1, J12.17 (GPIO_15)
unnamed: GPIO1_16.1, J12.20 (GPIO_16)
unnamed: GPIO1_17.1, J12.19 (GPIO_17)
unnamed: GPIO1_18.1, J12.22 (GPIO_18)
unnamed: GPIO1_19.1, J12.21 (GPIO_19)
unnamed: GPIO1_20.1, J12.24 (GPIO_20)
unnamed: GPIO1_21.1, J12.23 (GPIO_21)
unnamed: GPIO1_22.1, J12.26 (GPIO_22)
unnamed: GPIO1_23.1, J12.25 (GPIO_23)
unnamed: GPIO1_24.1, J12.28 (GPIO_24)
unnamed: GPIO1_25.1, J12.27 (GPIO_25)
unnamed: GPIO1_26.1, J12.32 (GPIO_26)
unnamed: GPIO1_27.1, J12.31 (GPIO_27)
unnamed: GPIO1_29.1, J12.33 (GPIO_29)
unnamed: GPIO1_31.1, J12.35 (GPIO_31)
unnamed: GPIO1_32.1, J12.38 (GPIO_32)
unnamed: GPIO1_33.1, J12.37 (GPIO_33)
unnamed: GPIO1_34.1, J12.40 (GPIO_34)

Notes on the sheet:
I2S0 = MCLK I2S1 = BCK I2S2 = DATA I2S3 = LRCK
I2C0 = SCL I2C1 = SDA
SPI0 = CLK SPI1 = MOSI SPI2 = MISO SPI3 = CS

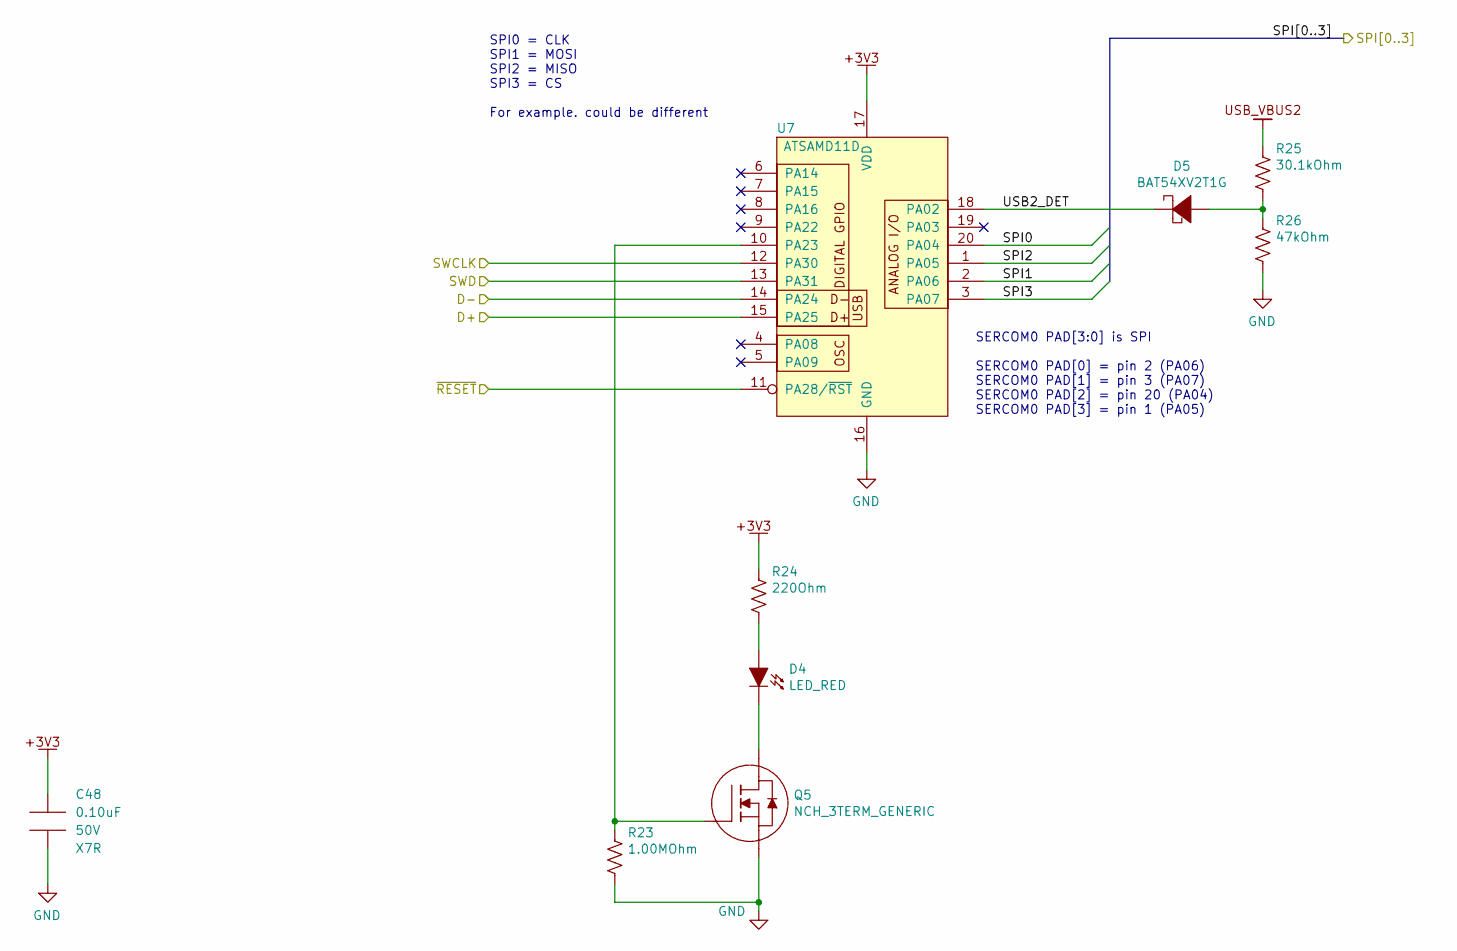
[picture p12: schematic USB_SPI.sch, USB To SPI Converter]

Parts:
C48: 0.10uF; CAP_0603; Voltage 50V; Tolerance XX %
D4: LED_RED; LED_0805
D5: BAT54XV2T1G; SOD-523
Q5: NCH_3TERM_GENERIC; SOT23
R23: 1.00MOhm; RES_0603; Tolerance 10 %
R24: 220Ohm; RES_0603; Tolerance XX %
R25: 30.1kOhm; RES_0603; Tolerance XX %
R26: 47kOhm; RES_0603; Tolerance XX %
U7: ATSAMD11D; SOIC-20; MFG1 P/N ATSAMD11D14A-SSUT

Connections:
3V3: C48.1, R24.1, U7.17 (VDD); also elsewhere on the board
/FPGA Interface/SPI0: U7.20 (PA04); also elsewhere on the board
/FPGA Interface/SPI1: U7.2 (PA06); also elsewhere on the board
/FPGA Interface/SPI2: U7.1 (PA05); also elsewhere on the board
/FPGA Interface/SPI3: U7.3 (PA07); also elsewhere on the board
/SPI_USB_D_+: U7.15 (PA25); also elsewhere on the board
/SPI_USB_D_-: U7.14 (PA24); also elsewhere on the board
/USB <-> SPI/SWCLK: U7.12 (PA30); also elsewhere on the board
/USB <-> SPI/SWD: U7.13 (PA31); also elsewhere on the board
/USB <-> SPI/USB2_DET: D5.2, U7.18 (PA02)
/USB <-> SPI/~RESET: U7.11 (PA28/~RST); also elsewhere on the board
GND: C48.2, Q5.2 (S), R23.2, R26.2, U7.16 (GND); also elsewhere on the board
unnamed: D4.1, R24.2
unnamed: D4.2, Q5.3 (D)
unnamed: D5.1, R25.2, R26.1
unnamed: Q5.1 (G), R23.1, U7.10 (PA23)
USB_VBUS2: R25.1; also elsewhere on the board

Notes on the sheet:
SPI0 = CLK SPI1 = MOSI SPI2 = MISO SPI3 = CS For example. could be different
SERCOM0 PAD[3:0] is SPI SERCOM0 PAD[0] = pin 2 (PA06) SERCOM0 PAD[1] = pin 3 (PA07) SERCOM0 PAD[2] = pin 20 (PA04) SERCOM0 PAD[3] = pin 1 (PA05)
