kairotronix/kt_sound_pcb/kt_sound_prototypeiface.kicad_pcb

## KiCad design kt_sound_prototypeiface.kicad_pcb (continued)

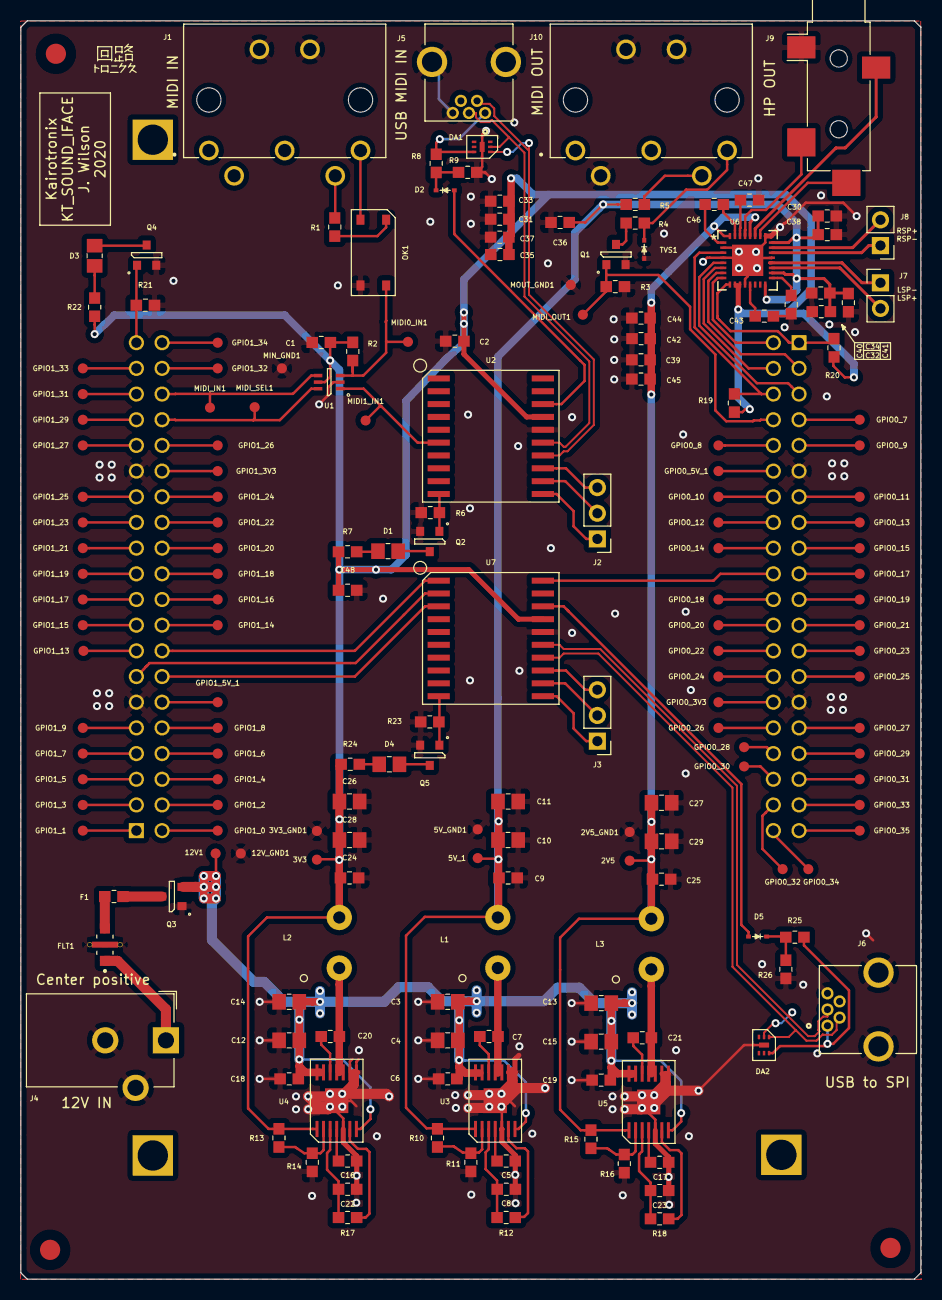
[picture p13: board kt_sound_prototypeiface.kicad_pcb from above]

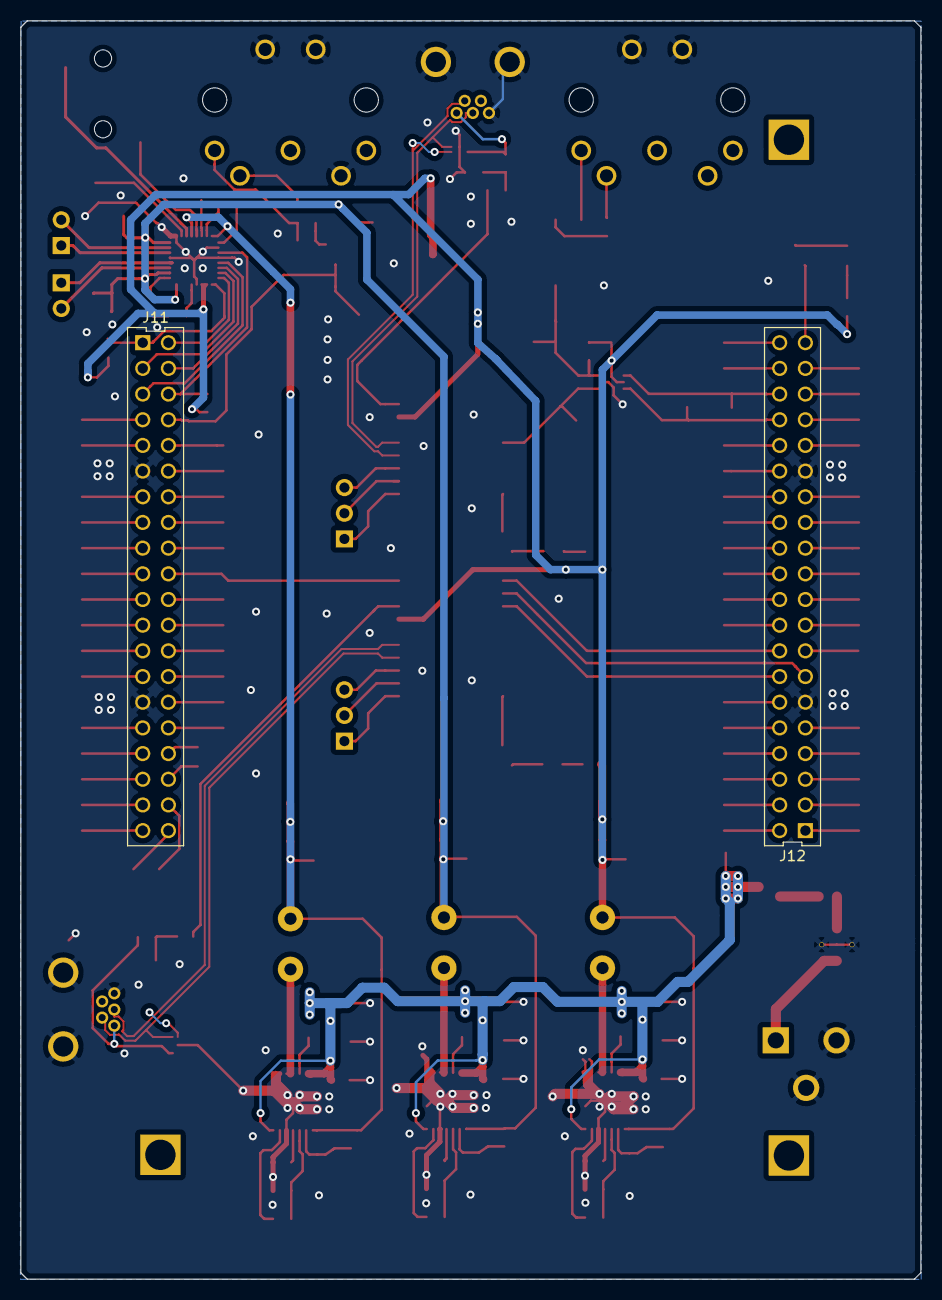
[picture p14: board kt_sound_prototypeiface.kicad_pcb from below]

Board: 2 copper layers, 89.0 x 124.5 mm, 192 parts (2 on the bottom side), 146 nets.
