kairotronix/kt_sound_pcb/(commit log)

2020-05-03 Initial upload
    Initial upload of project PCB files. Contains schematics and PCB file.
    [AUDIO_OUTPUT.sch, FPGA_IFACE.sch, POWER_MGMT.sch, USB_I2C.sch, USB_MIDI_IFACE.sch, USB_SPI.sch, USB_UART.sch, kt_sound_prototypeiface.kicad_pcb]
2020-05-03 A little bit of cleanup pre-verification of the schematic.
2020-05-03 Noticed issue in POWER_MGMT.sch. Connected enable to VCC, routed changes accordingly.
    [POWER_MGMT.sch, kt_sound_prototypeiface.kicad_pcb]
2020-05-03 Adding some more thermal vias on power circuitry.
    Moved some reference designators to a more logical location
    TODO:
    *Finish verification of audio amp
    *Finish verification of USB to MIDI/SPI circuits
    *Confirm footprints against datasheets for active components and unique passives.
    [kt_sound_prototypeiface.kicad_pcb]
2020-05-03 Added comments in USB schematics.
    Put SPI on SERCOM0 in USB_SPI.sch, in routing realized it would be easier to split SPI between GPIO. This may be an issue in the future or may limit maximum SPI frequency.
    [FPGA_IFACE.sch, USB_MIDI_IFACE.sch, USB_SPI.sch, kt_sound_prototypeiface.kicad_pcb]
2020-05-03 Updated schematic. DVDD was set to 5V but it was meant to be set to 3V3, likewise VDD was set to 3V3 but was meant to be set to 5V.
    Updated PCB for schematic changes.
    Updated PCB to single sided construction (for SMT parts) by moving the diode arrays to the top. This may cause some issues with USB due to stray capacitance but things will likely be fine at USB full speed.
    [AUDIO_OUTPUT.sch, kt_sound_prototypeiface.kicad_pcb]
2020-05-03 Saved files and confirmed everything was OK one last time.
    [AUDIO_OUTPUT.sch, kt_sound_prototypeiface.kicad_pcb]
2020-05-04 Added fiducials to the PCB in 3 corners. Moved some silk to accommodate this.
    [kt_sound_prototypeiface.kicad_pcb]
2020-05-05 Using the DXF of the DE10-Nano devkit I ensured placement of critical components was adequate. Mounting holes were moved slightly to ensure proper alignment.
    One GND via was added near the I2S amplifier to ensure a stronger gnd connection.
    [kt_sound_prototypeiface.kicad_pcb]
2020-05-06 Updated SMT PCB footprints and updated PCB. Added surface mount device flag so they would be added to the pick and place file.
    [kt_sound_prototypeiface.kicad_pcb]
2020-05-19 Added files for fabrication. Added PDF of schematics. Fixed minor issue in PCB footprint and updated PCB accordingly. Added symbol cache so schematics can be viewed in kicad without having my persona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
    [kt_sound_prototypeiface-B_Cu.gbr, kt_sound_prototypeiface-B_Mask.gbr, kt_sound_prototypeiface-B_Paste.gbr, kt_sound_prototypeiface-B_SilkS.gbr, kt_sound_prototypeiface-Edge_Cuts.gbr, kt_sound_prototypeiface-F_Cu.gbr, kt_sound_prototypeiface-F_Mask.gbr, kt_sound_prototypeiface-F_Paste.gbr]
